RobotisMollis/TeMoG/(list of files, cad)

Other CAD files:
TeMoG-part3a-TopPiece-solid disk.scad
TeMoG-part4b-FinishingMold - smaller.scad
TeMoG-ResultingCast.scad
